versioduo/drum/drum.pdf

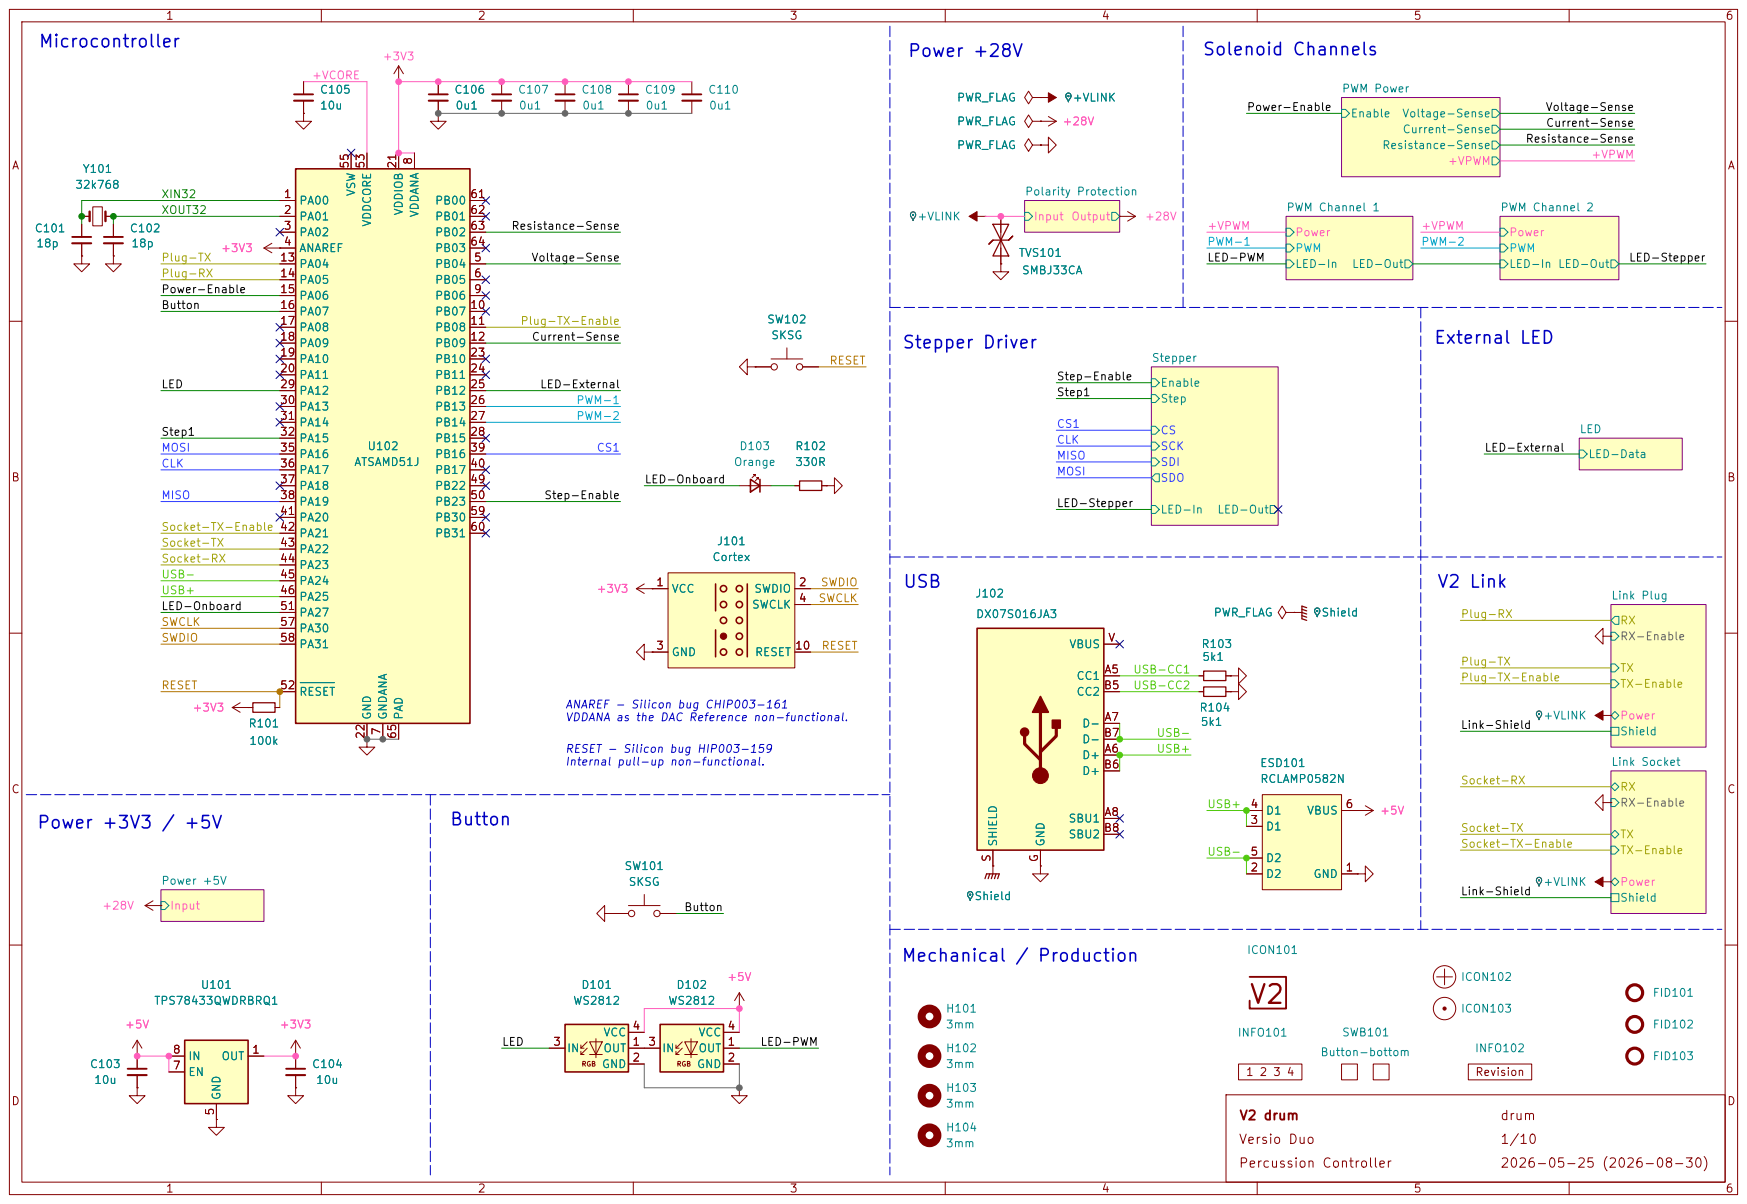
[picture p1: page 1]

Voltage-Sense Resistance-Sense +VPWM

XOUT32
Socket-RX Button Plug-TX Power-Enable Plug-RX

LED-Out Power PWM Channel 1

LED-Out Power PWM Channel 2

Stepper Driver | PWM-2 RESET

PWM-1 Plug-TX-Enable

Enable SDI LED-In SCK
Step

Step1 MOSI LED-Stepper CLK

LED-Onboard Socket-TX CLK

USB

TX-Enable Power Shield

ANAREF - Silicon bug CHIP003-161
VDDANA as the DAC Reference non-functional. RESET - Silicon bug HIP003-159

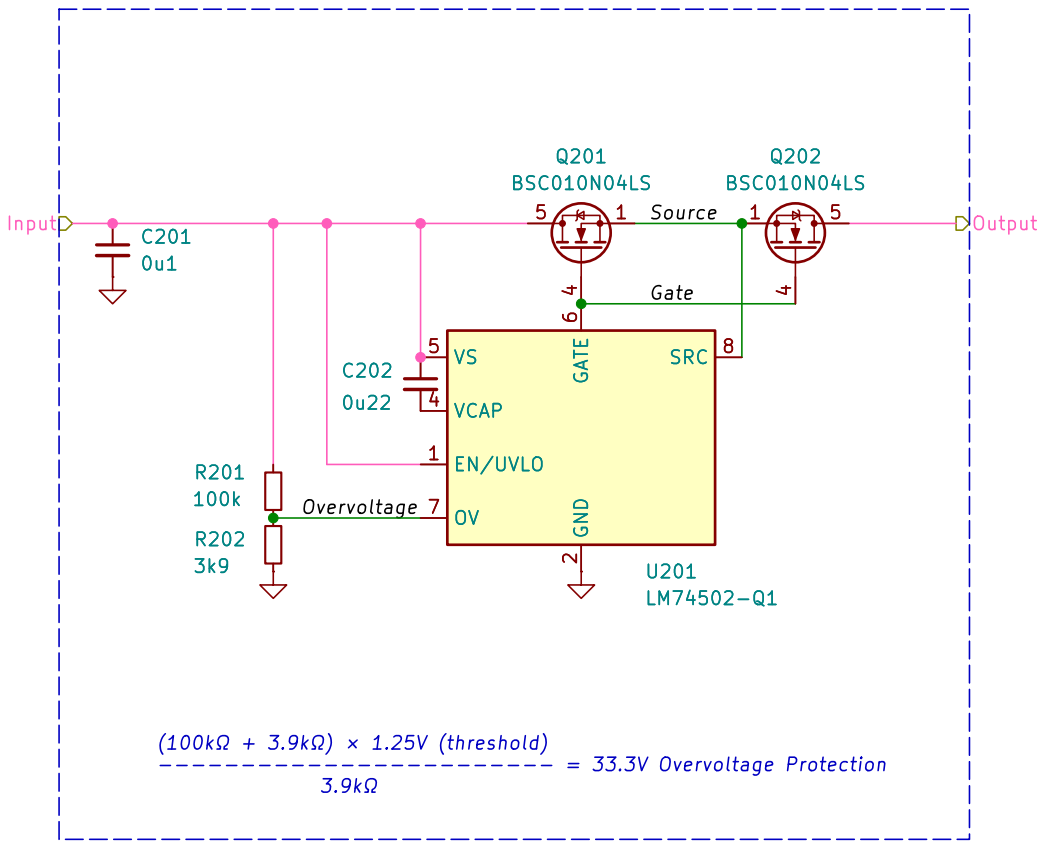
[picture p2: page 2]

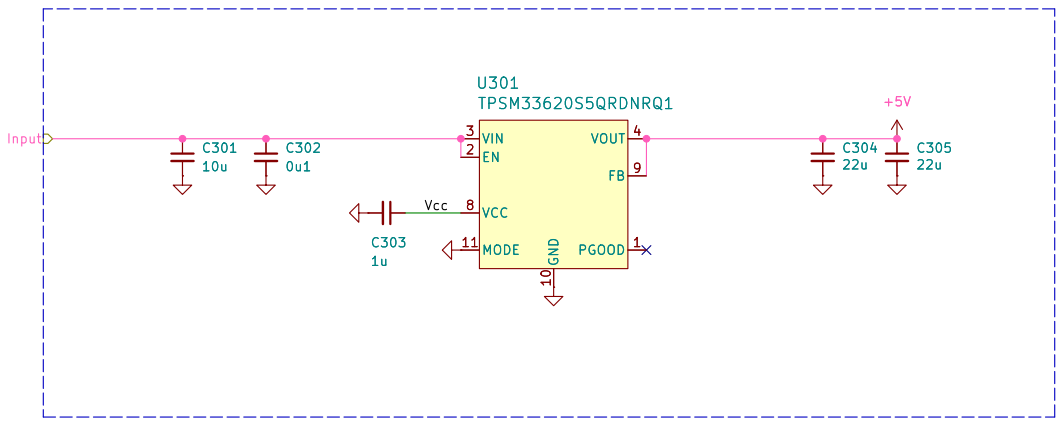
[picture p3: page 3]

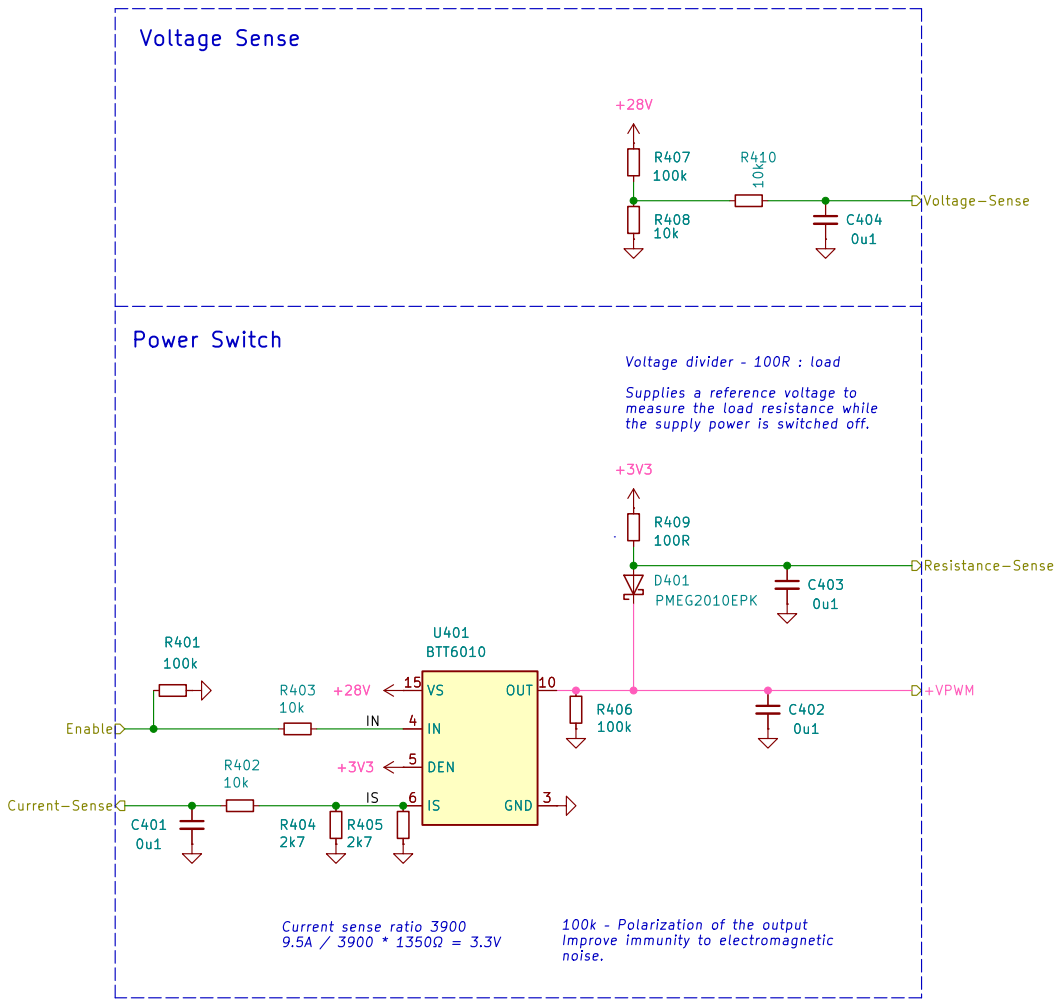
[picture p4: page 4]

Voltage divider – 100R : load Supplies a reference voltage to measure the load resistance while

the supply power is switched off. 100k – Polarization of the output

Improve immunity to electromagnetic noise.

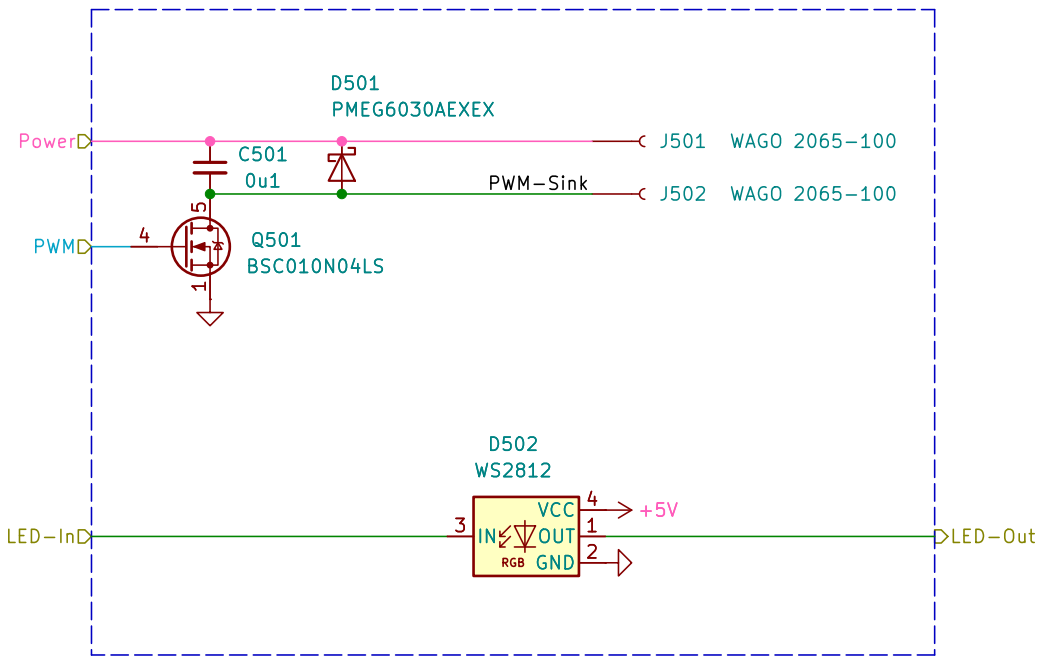
[picture p5: page 5]

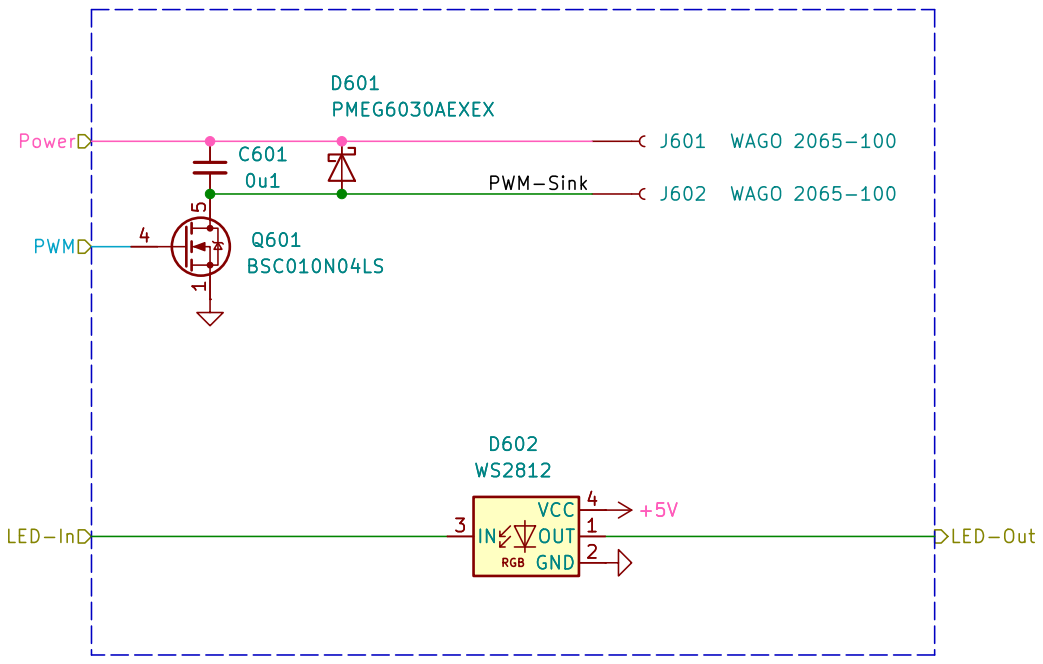
[picture p6: page 6]

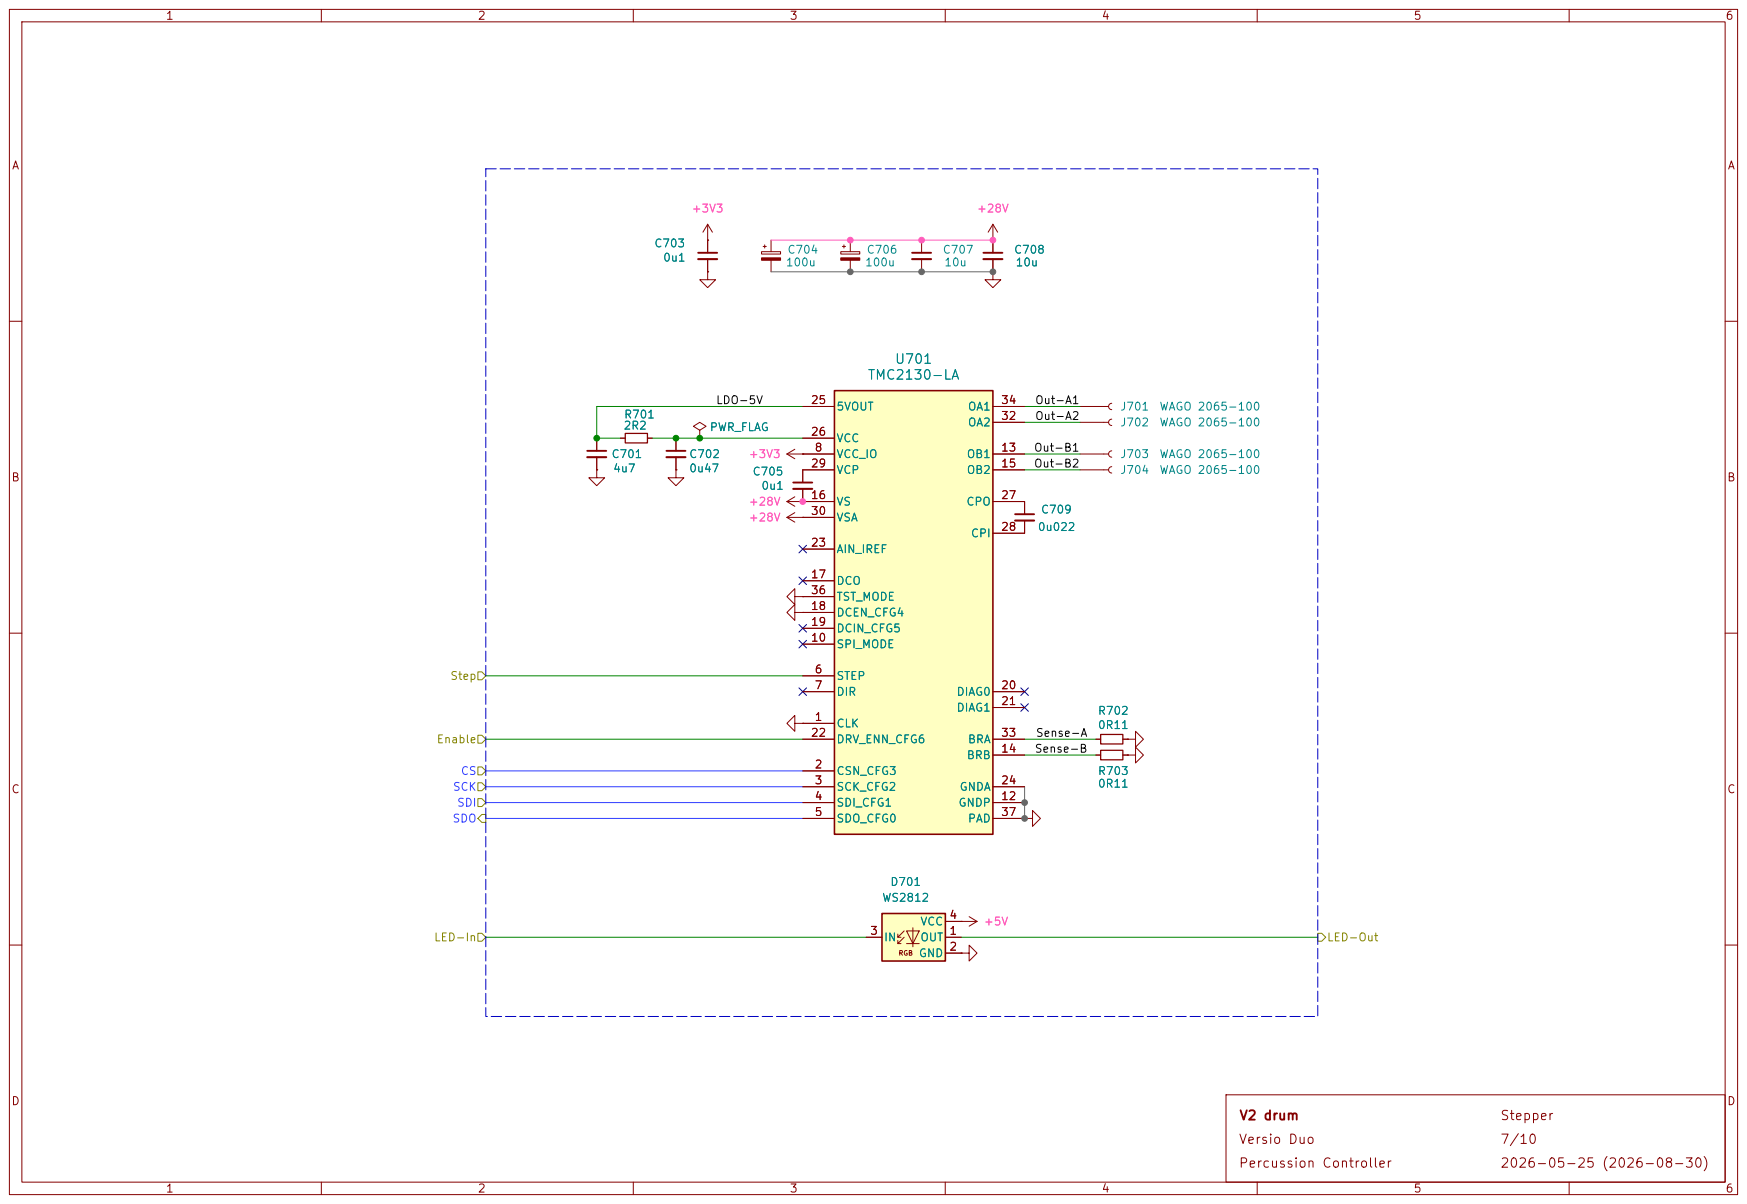
[picture p7: page 7]

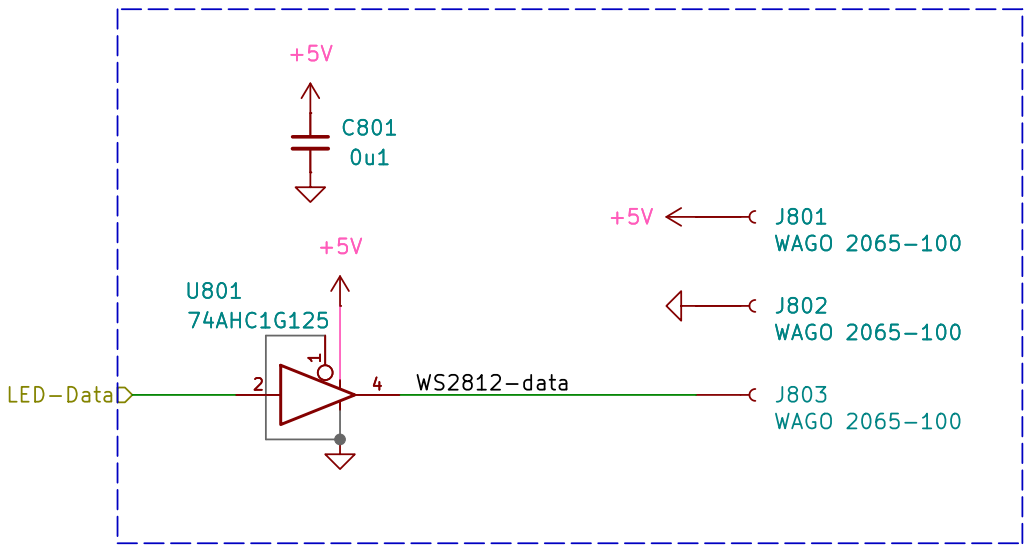
[picture p8: page 8]

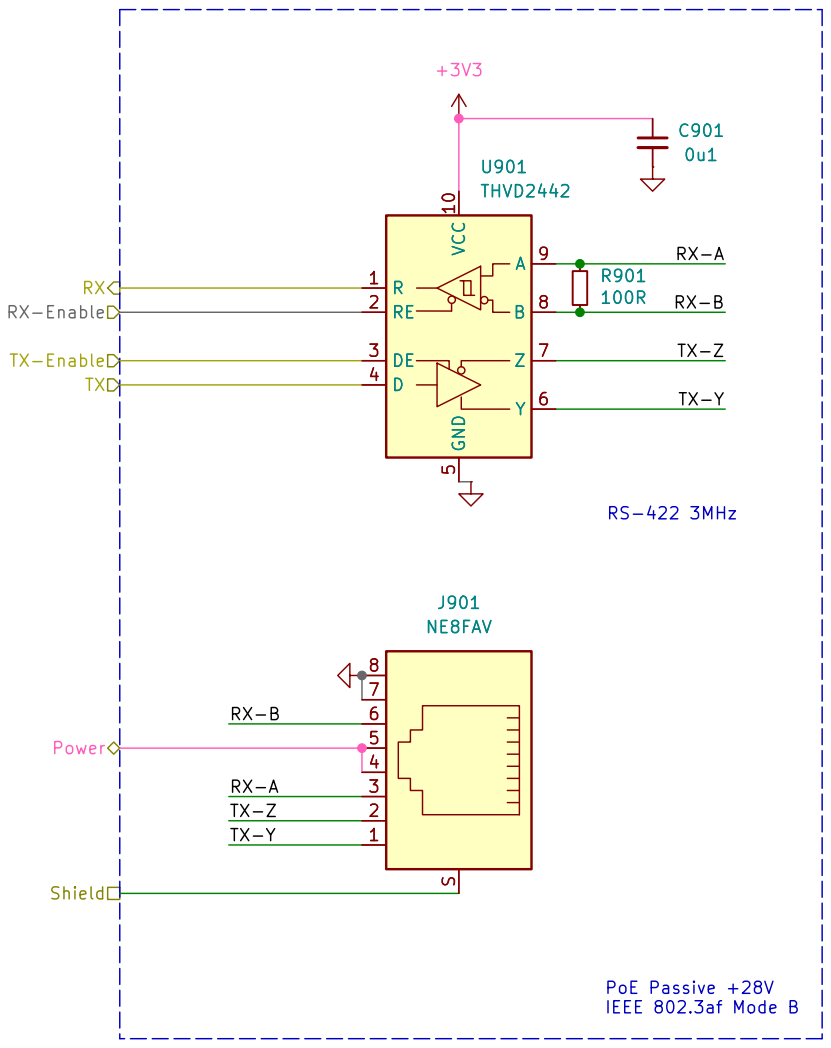
[picture p9: page 9]

Shield Power RX-Enable

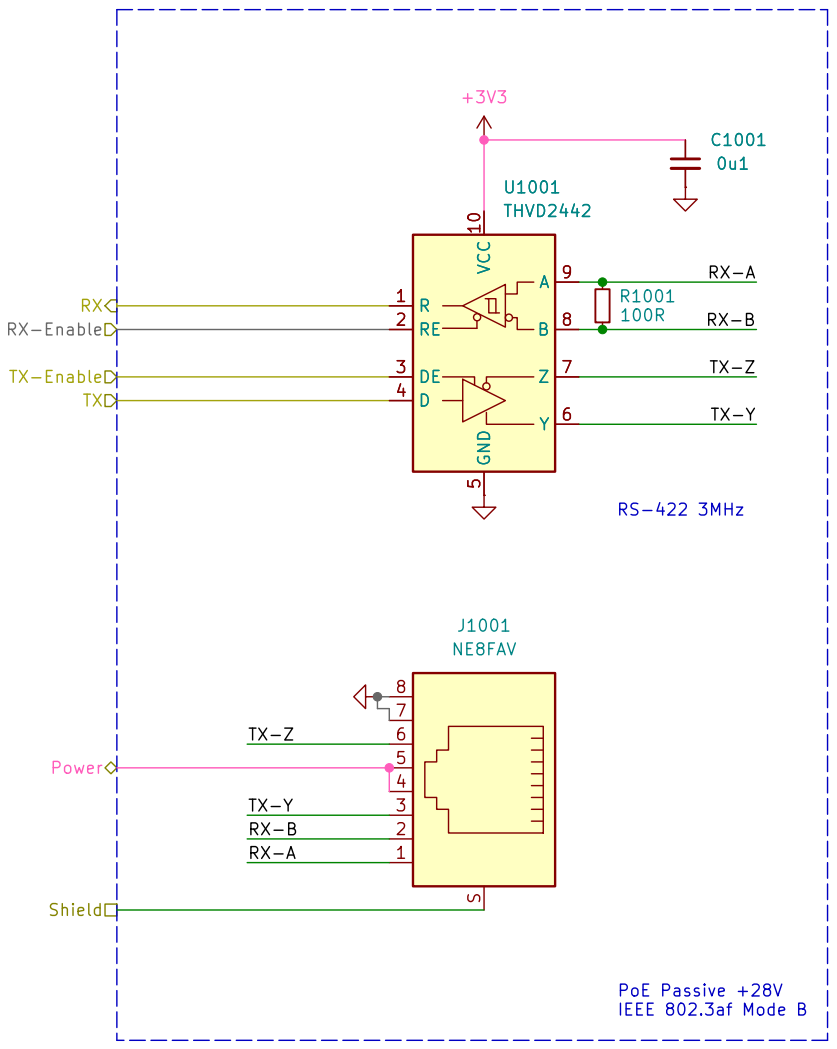
[picture p10: page 10]

IEEE 802.3af Mode B U1001
THVD2442
TX-Z RX-A RS-422 3MHz PoE Passive +28V

TX-Enable RX RX-Enable
