versioduo/drum/drum.kicad_pcb

## KiCad design drum.kicad_pcb (2026-08-30)

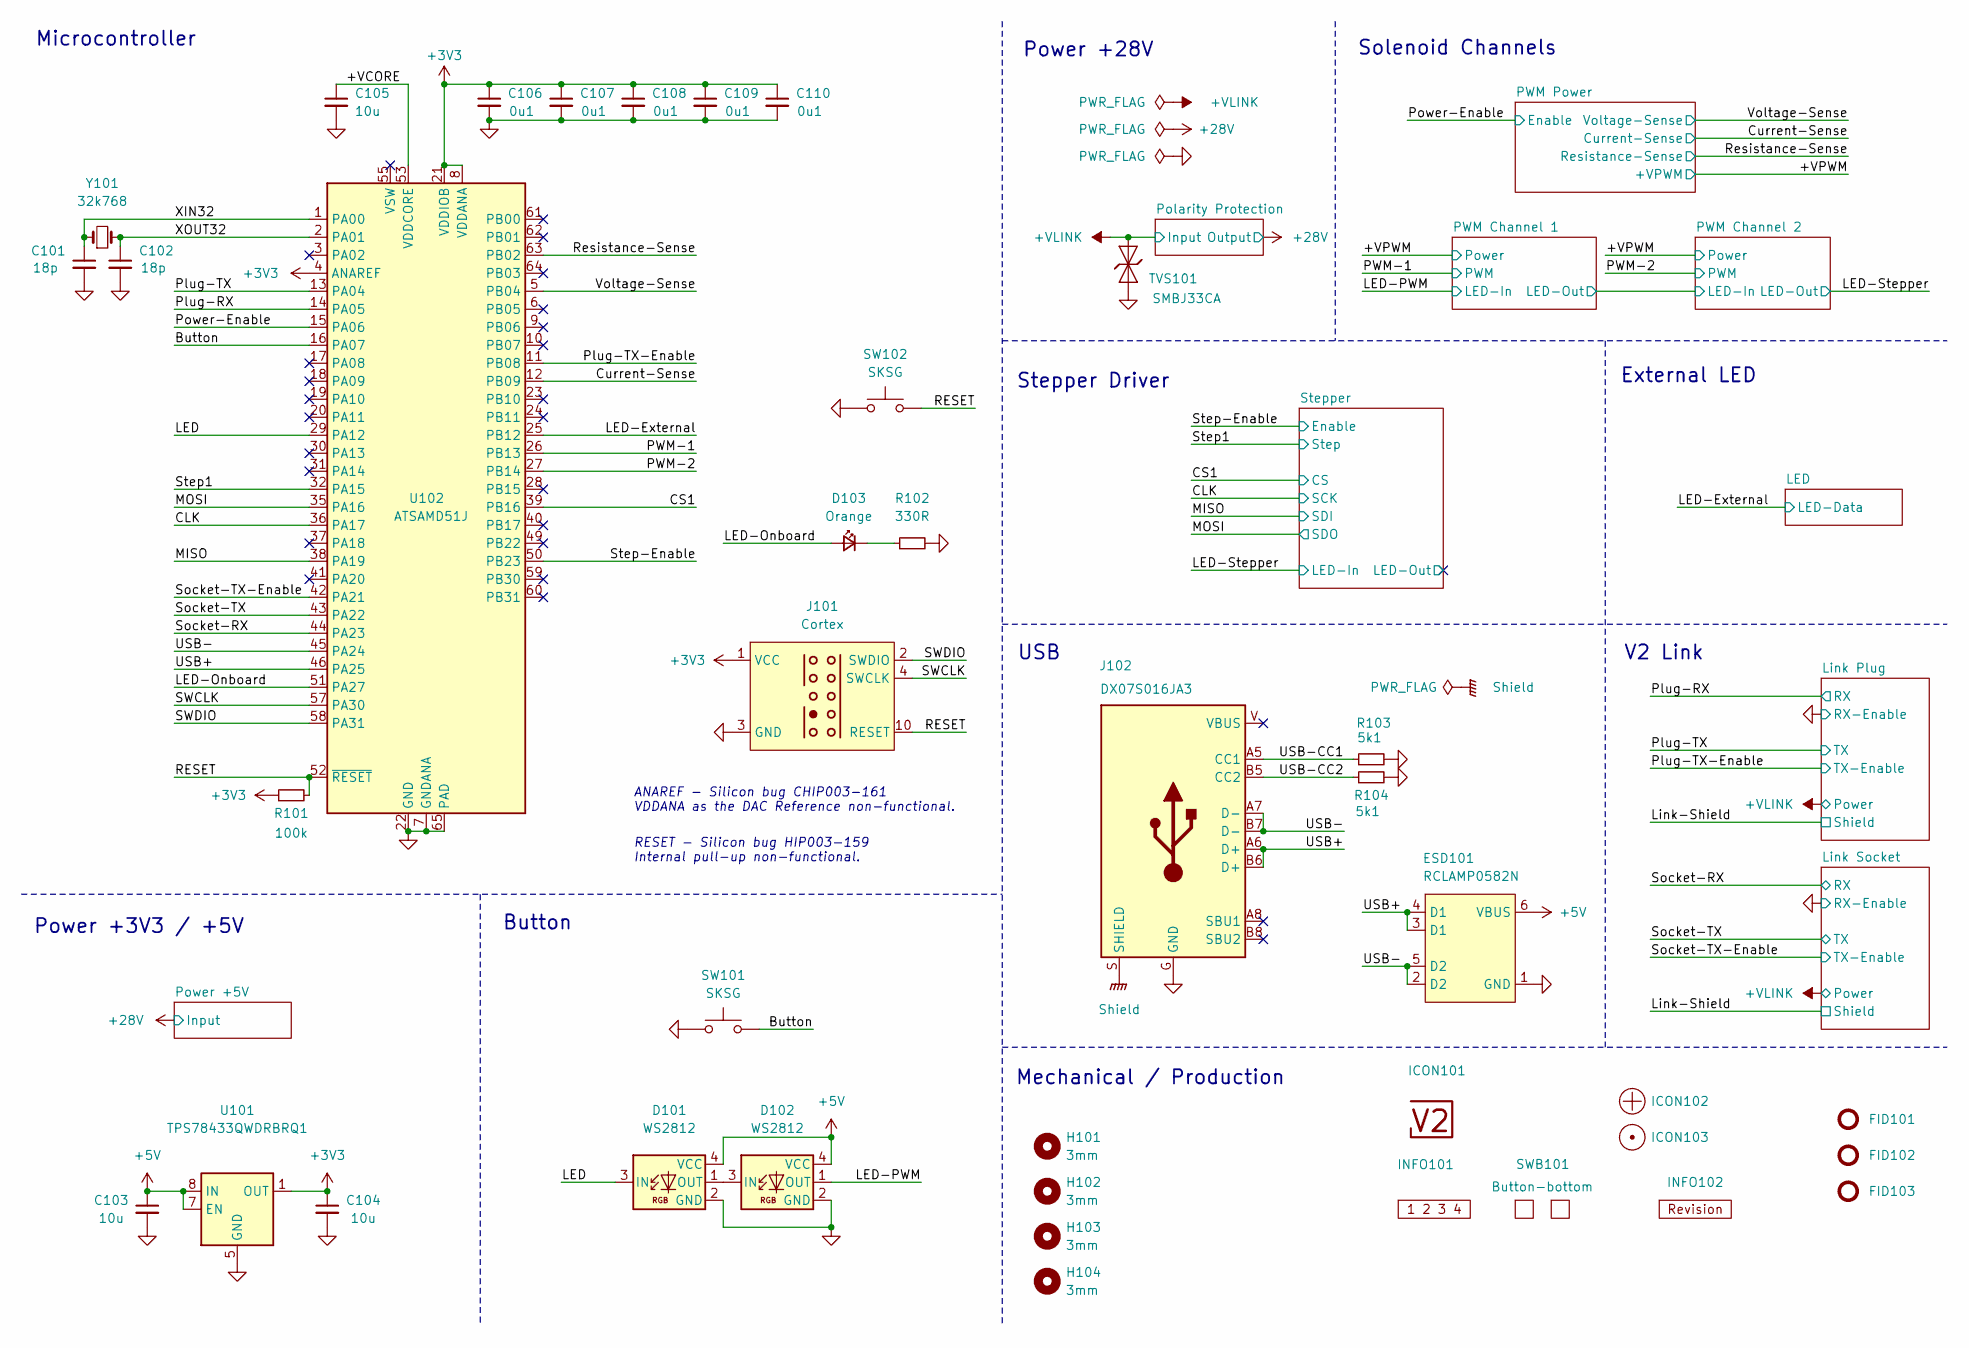
[picture p11: schematic drum.kicad_sch, V2 drum]

Parts:
C101, C102: 18p; C_1608; Rating 50V; Mouser 810-CGA3E2C0G1H180J
C103, C104: 10u; C_2012; Rating 25V; Mouser 810-C2012X5R1E106K
C105: 10u; C_1608; Rating 10V; Mouser 810-C1608X6S1A106M
C106, C107, C108, C109, C110: 0u1; C_1608; Rating 50V; Mouser 810-CGA3E2X7R1H104MA
D101, D102: WS2812; WS2812-2020; Rating 15mA; LCSC C965555
D103: Orange; LED_1608; Rating 605nm; Mouser 755-SML-D12D1WT86
ESD101: RCLAMP0582N; SLP1210N6; Rating 20kV; Mouser 947-RCLAMP0582N.TCT
FID101, FID102, FID103: Fiducial_Paste; Fiducial_0.5mm_Mask1mm_Paste
H101, H102, H103, H104: 3mm; MountingHole_3mm
ICON101: V2-logo; Logo_Small
ICON102: Plus; Plus_Small
ICON103: Dot; Dot_Small
INFO101: Layer_Numbers-6
INFO102: Revision
J101: Cortex
J102: DX07S016JA3; JAE_DX07S016JA3; Rating USB2.0; Mouser 656-DX07S016JA3R1500
R101: 100k; R_1608; Rating 100mW; Mouser 71-CRCW0603100KFKEAC
R102: 330R; R_1608; Rating 100mW; Mouser 71-CRCW0603330RFKEAC
R103, R104: 5k1; R_1608; Rating 100mW; Mouser 71-CRCW06035K10FKEAC
SW101, SW102: SKSG; Rating 1.6N; Mouser 688-SKSGACE010
SWB101: Button-bottom; PCB_Button-bottom
TVS101: SMBJ33CA; D_SMB; Rating 33V; Mouser 652-SMBJ33CA-Q
U101: TPS78433QWDRBRQ1; VSON-8-1_3x3mm_P0.65_EP1.65x2.4mm; Rating 300mA; Mouser 595-TPS78433QWDRBRQ1
U102: ATSAMD51J; QFN-64-1EP_9x9mm_P0.5mm_EP4.8x4.8mm_ThermalVias; Rating Cortex-M4F; Mouser 556-ATSAMD51J19AMU
Y101: 32k768; Crystal_SMD_3215-2Pin_3.2x1.5mm; Rating 10ppm; Mouser 815-ABS0716632.768KT

Connections:
+3V3: C104.1, C106.1, C107.1, C108.1, C109.1, C110.1, J101.1 (VCC), R101.1, U101.1 (OUT), U102.4 (ANAREF), U102.8 (VDDANA), U102.21 (VDDIOB), U102.34 (VDDIO), U102.48 (VDDIO), U102.56 (VDDIO); also elsewhere on the board
+5V: C103.1, D101.4 (VCC), D102.4 (VCC), ESD101.6 (VBUS), U101.6 (EN), U101.7 (EN), U101.8 (IN); also elsewhere on the board
/+VCORE: C105.1, U102.53 (VDDCORE)
/+VLINK: TVS101.2 (A); also elsewhere on the board
/Button: SW101.2, U102.16 (PA07)
/CLK: U102.36 (PA17); also elsewhere on the board
/CS1: U102.39 (PB16); also elsewhere on the board
/Current-Sense: U102.12 (PB09); also elsewhere on the board
/LED: D101.3 (IN), U102.29 (PA12)
/LED-External: U102.25 (PB12); also elsewhere on the board
/LED-Onboard: D103.2 (A), U102.51 (PA27)
/LED-PWM: D102.1 (OUT); also elsewhere on the board
/MISO: U102.38 (PA19); also elsewhere on the board
/MOSI: U102.35 (PA16); also elsewhere on the board
/PWM-1: U102.26 (PB13); also elsewhere on the board
/PWM-2: U102.27 (PB14); also elsewhere on the board
/Plug-RX: U102.14 (PA05); also elsewhere on the board
/Plug-TX: U102.13 (PA04); also elsewhere on the board
/Plug-TX-Enable: U102.11 (PB08); also elsewhere on the board
/Power-Enable: U102.15 (PA06); also elsewhere on the board
/RESET: J101.10 (RESET), R101.2, SW102.2, U102.52 (~RESET)
/Resistance-Sense: U102.63 (PB02); also elsewhere on the board
/SWCLK: J101.4 (SWCLK), U102.57 (PA30)
/SWDIO: J101.2 (SWDIO), U102.58 (PA31)
/Shield: J102.S (SHIELD)
/Socket-RX: U102.44 (PA23); also elsewhere on the board
/Socket-TX: U102.43 (PA22); also elsewhere on the board
/Socket-TX-Enable: U102.42 (PA21); also elsewhere on the board
/Step1: U102.32 (PA15); also elsewhere on the board
/Step-Enable: U102.50 (PB23); also elsewhere on the board
/USB+: ESD101.3 (D1), ESD101.4 (D1), J102.A6 (D+), J102.B6 (D+), U102.46 (PA25)
/USB-: ESD101.2 (D2), ESD101.5 (D2), J102.A7 (D-), J102.B7 (D-), U102.45 (PA24)
/USB-CC1: J102.A5 (CC1), R103.1
/USB-CC2: J102.B5 (CC2), R104.1
/Voltage-Sense: U102.5 (PB04); also elsewhere on the board
/XIN32: C101.1, U102.1 (PA00), Y101.1
/XOUT32: C102.1, U102.2 (PA01), Y101.2
GND: C101.2, C102.2, C103.2, C104.2, C105.2, C106.2, C107.2, C108.2, C109.2, C110.2, D101.2 (GND), D102.2 (GND), ESD101.1 (GND), J101.3 (GND), J101.5 (GND), J102.G (GND), R102.2, R103.2, R104.2, SW101.1, SW102.1, TVS101.1 (K), U101.5 (GND), U101.9 (GND), U102.7 (GNDANA), U102.22 (GND), U102.33 (GND), U102.47 (GND), U102.54 (GND), U102.65 (PAD); also elsewhere on the board
unnamed: D101.1 (OUT), D102.3 (IN)
unnamed: D103.1 (K), R102.1

Notes on the sheet:
 ANAREF - Silicon bug CHIP003-161 VDDANA as the DAC Reference non-functional.
Solenoid Channels
RESET -  Silicon bug HIP003-159 Internal pull-up non-functional.
Button
USB
Mechanical / Production
External LED
Power +3V3 / +5V
Stepper Driver
V2 Link
Microcontroller
Power +28V

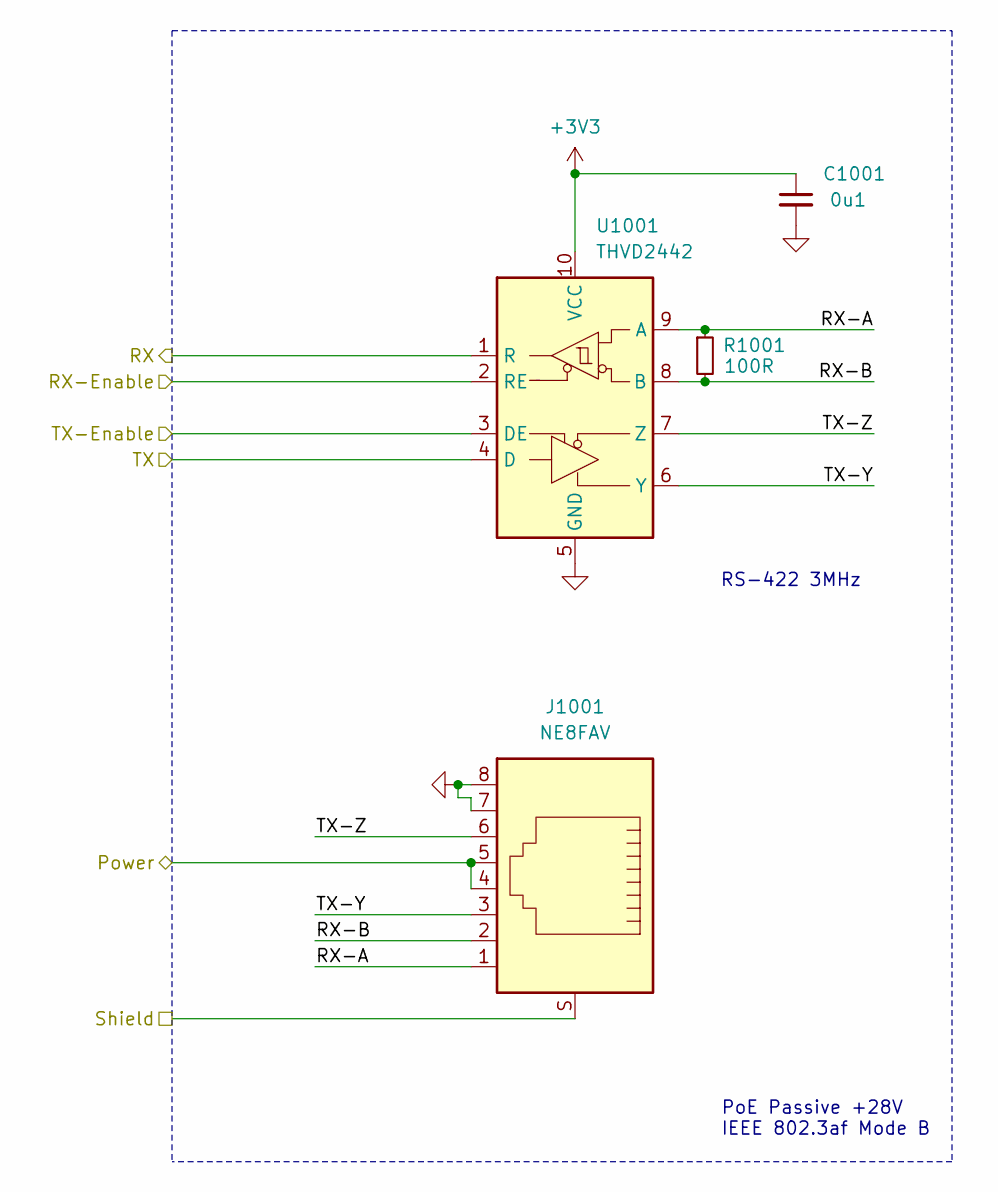
[picture p12: schematic Link-Socket.kicad_sch, V2 drum]

Parts:
C1001: 0u1; C_1608; Rating 50V; Mouser 810-CGA3E2X7R1H104MA
J1001: NE8FAV; Rating CAT5e; Mouser 568-NE8FAV-SD
R1001: 100R; R_1608; Rating 330mW; Mouser 71-CRCW0603100RFKEAH
U1001: THVD2442; VSON-10-4-1EP_3x3mm_P0.5mm_EP1.65x2.4mm_ThermalVias; Rating 20Mbps; Mouser 595-THVD2442DRCR

Connections:
+3V3: C1001.1, U1001.10 (VCC); also elsewhere on the board
/+VLINK: J1001.4, J1001.5; also elsewhere on the board
/Link Socket/RX-A: J1001.1, R1001.1, U1001.9 (A)
/Link Socket/RX-B: J1001.2, R1001.2, U1001.8 (B)
/Link Socket/TX-Y: J1001.3, U1001.6 (Y)
/Link Socket/TX-Z: J1001.6, U1001.7 (Z)
/Link-Shield: J1001.S; also elsewhere on the board
/Socket-RX: U1001.1 (R); also elsewhere on the board
/Socket-TX: U1001.4 (D); also elsewhere on the board
/Socket-TX-Enable: U1001.3 (DE); also elsewhere on the board
GND: C1001.2, J1001.7, J1001.8, U1001.2 (RE), U1001.5 (GND), U1001.11 (GND); also elsewhere on the board

Notes on the sheet:
PoE Passive +28V IEEE 802.3af Mode B
RS-422 3MHz

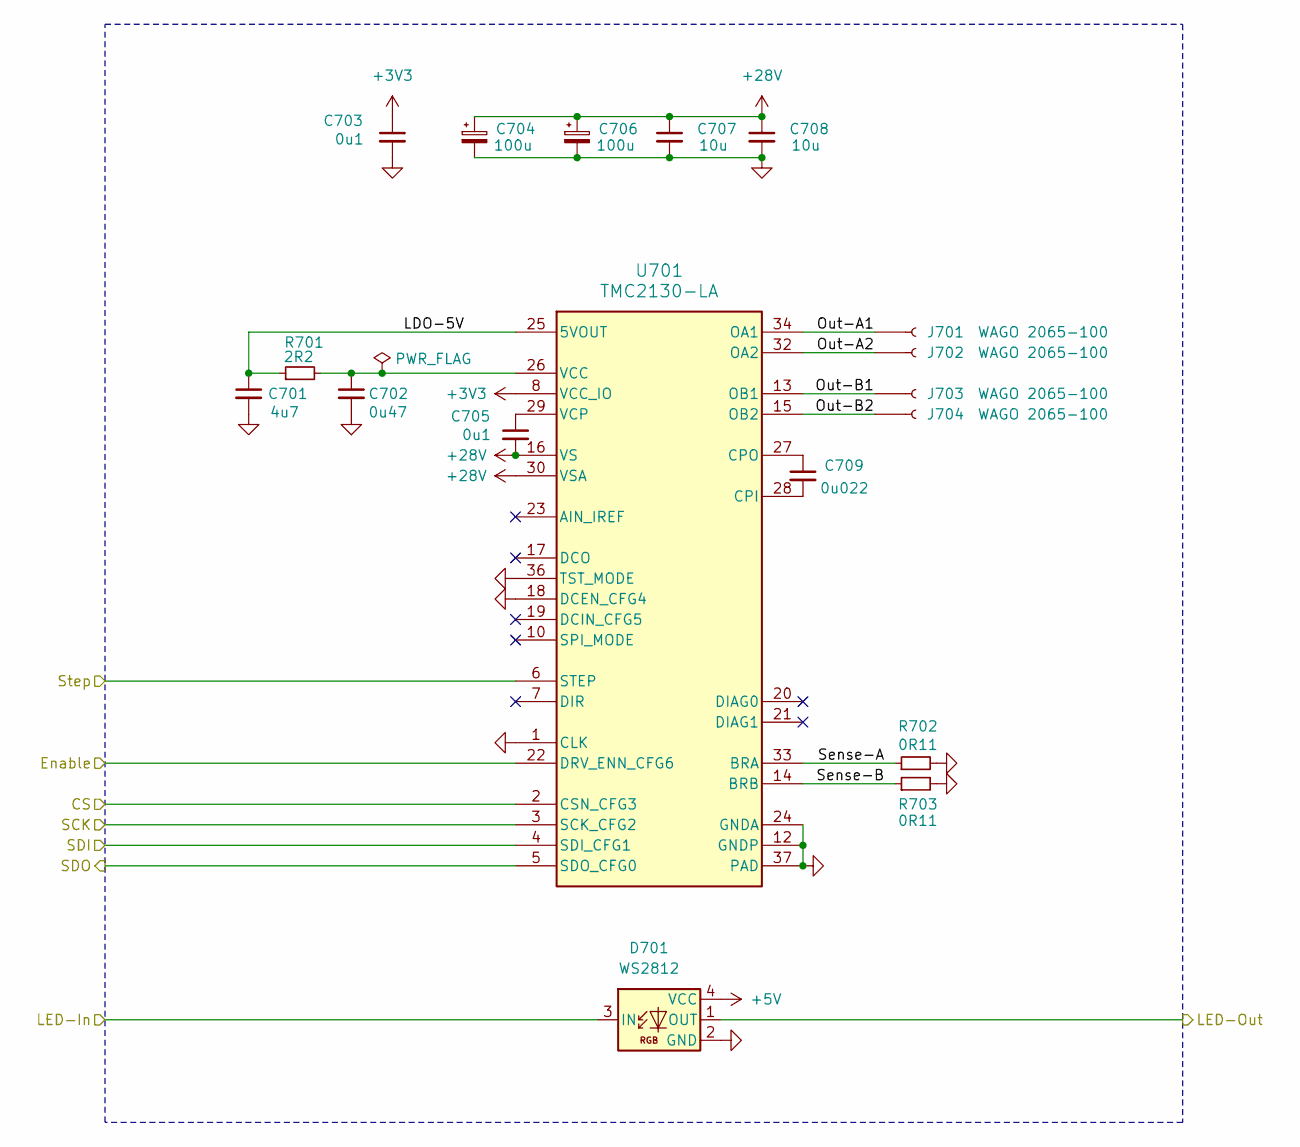
[picture p13: schematic Stepper.kicad_sch, V2 drum]

Parts:
C701: 4u7; C_1608; Rating 10V; Mouser 603-CC603KRX5R6BB475
C702: 0u47; C_1608; Rating 50V; Mouser 810-CGA3E3X7R1H474KB
C703, C705: 0u1; C_1608; Rating 50V; Mouser 810-CGA3E2X7R1H104MA
C704, C706: 100u; CP_Elec_6.3x7.7; Rating 35V; Mouser 667-EEE-FKV101XAL
C707, C708: 10u; C_3225; Rating 50V; Mouser 810-CNC6P1X7R1H106K2
C709: 0u022; C_1608; Rating 50V; Mouser 603-CC603KPX7R9BB223
D701: WS2812; WS2812-2020; Rating 15mA; LCSC C965555
J701, J702, J703, J704: WAGO 2065-100; 2065-100; Rating 9A
R701: 2R2; R_1608; Rating 500mW; Mouser 71-RCS06032R20JNEA
R702, R703: 0R11; R_2012; Rating 500mW; Mouser 667-ERJ-6DSFR11V
U701: TMC2130-LA; QFN-36-5X6; Rating 2A; LCSC C915795

Connections:
+3V3: C703.1, U701.8 (VCC_IO); also elsewhere on the board
+5V: D701.4 (VCC); also elsewhere on the board
+28V: C704.1, C705.2, C706.1, C707.1, C708.1, U701.16 (VS), U701.30 (VSA), U701.31 (VS); also elsewhere on the board
/CLK: U701.3 (SCK_CFG2); also elsewhere on the board
/CS1: U701.2 (CSN_CFG3); also elsewhere on the board
/LED-Stepper: D701.3 (IN); also elsewhere on the board
/MISO: U701.4 (SDI_CFG1); also elsewhere on the board
/MOSI: U701.5 (SDO_CFG0); also elsewhere on the board
/Step1: U701.6 (STEP); also elsewhere on the board
/Step-Enable: U701.22 (DRV_ENN_CFG6); also elsewhere on the board
/Stepper/LDO-5V: C701.1, R701.1, U701.25 (5VOUT)
/Stepper/LED-Out: D701.1 (OUT)
/Stepper/Out-A1: J701.1, U701.34 (OA1)
/Stepper/Out-A2: J702.1, U701.32 (OA2)
/Stepper/Out-B1: J703.1, U701.13 (OB1)
/Stepper/Out-B2: J704.1, U701.15 (OB2)
/Stepper/Sense-A: R702.1, U701.33 (BRA)
/Stepper/Sense-B: R703.1, U701.14 (BRB)
GND: C701.2, C702.2, C703.2, C704.2, C706.2, C707.2, C708.2, D701.2 (GND), R702.2, R703.2, U701.1 (CLK), U701.12 (GNDP), U701.18 (DCEN_CFG4), U701.24 (GNDA), U701.35 (GNDP), U701.36 (TST_MODE), U701.37 (PAD); also elsewhere on the board
unnamed: C709.2, U701.28 (CPI)
unnamed: C709.1, U701.27 (CPO)
unnamed: C702.1, R701.2, U701.26 (VCC)
unnamed: C705.1, U701.29 (VCP)

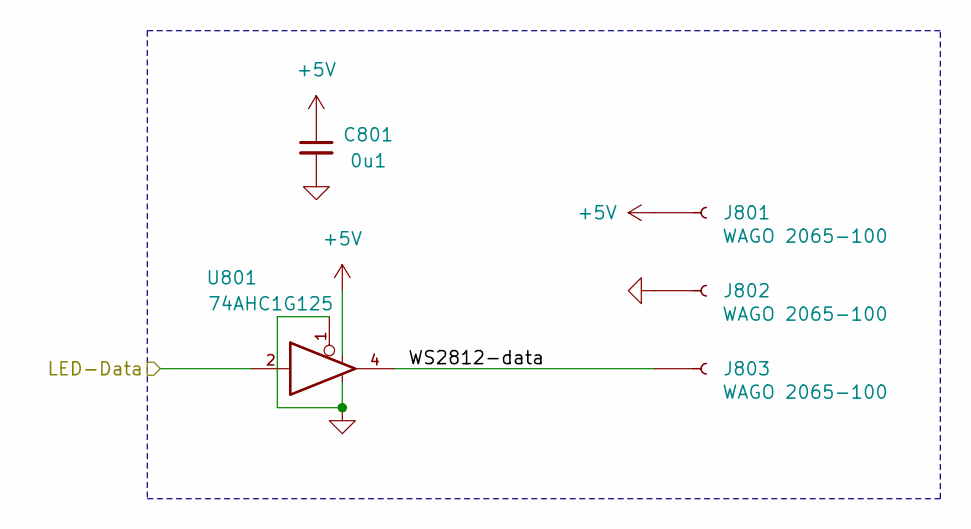
[picture p14: schematic LED.kicad_sch, V2 drum]

Parts:
C801: 0u1; C_1608; Rating 50V; Mouser 810-CGA3E2X7R1H104MA
J801, J802, J803: WAGO 2065-100; 2065-100; Rating 9A
U801: 74AHC1G125; SOT-23-5; Rating 8mA; Mouser 595-SN74AHC1G125DBVR

Connections:
+5V: C801.1, J801.1, U801.5; also elsewhere on the board
/LED-External: U801.2; also elsewhere on the board
/LED/WS2812-data: J803.1, U801.4
GND: C801.2, J802.1, U801.1, U801.3; also elsewhere on the board

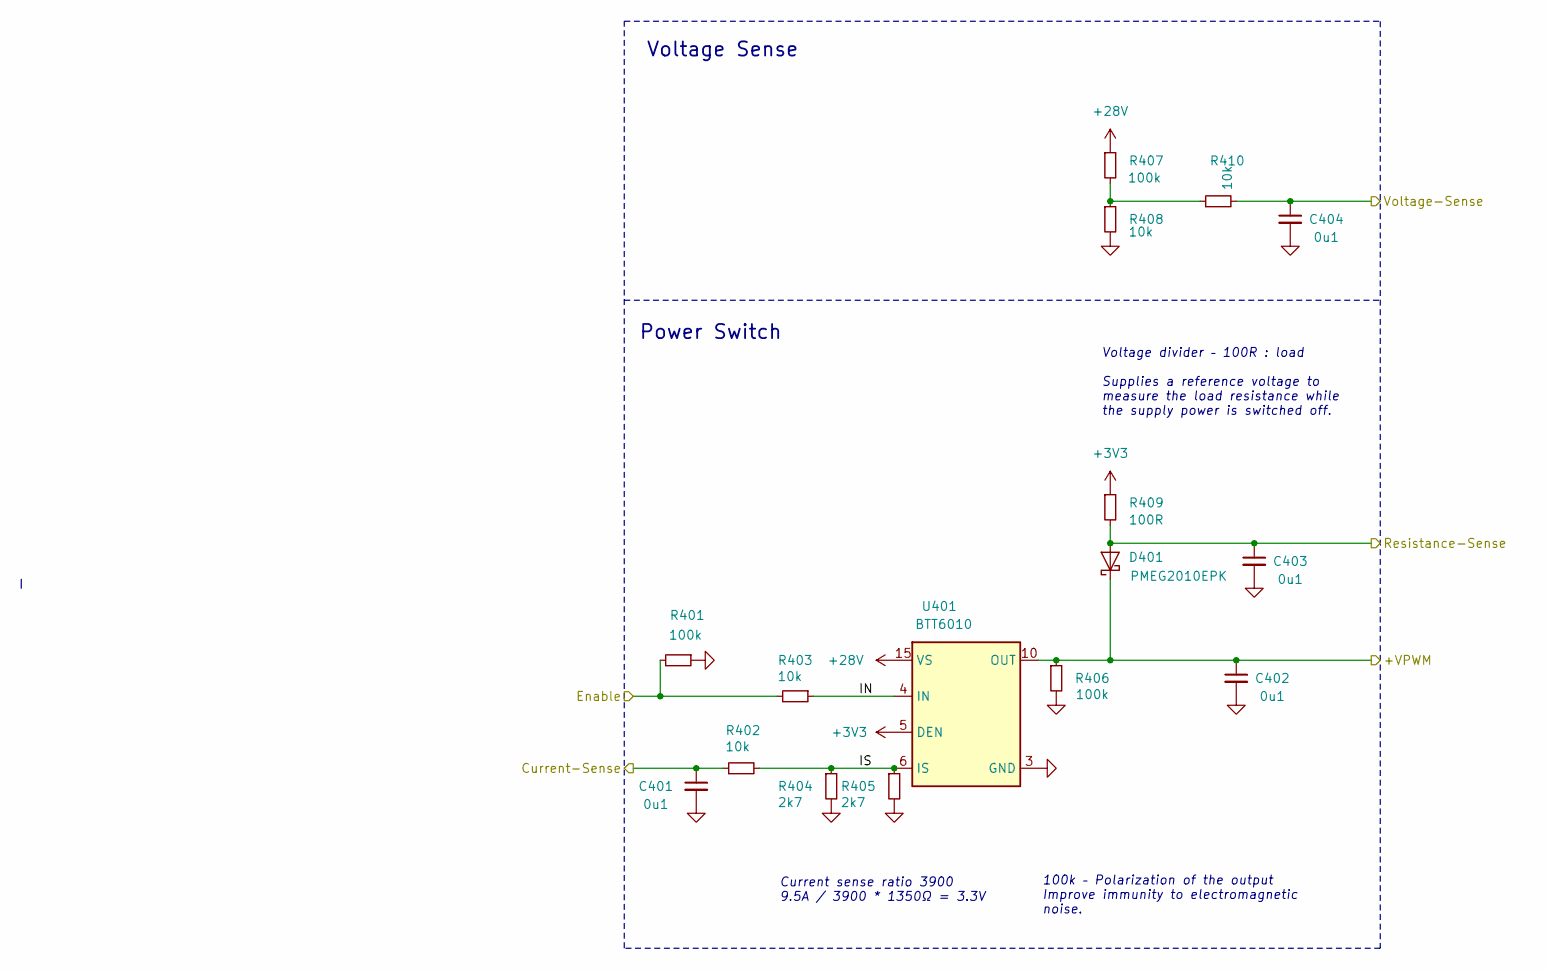
[picture p15: schematic Power-Switch.kicad_sch, V2 drum]

Parts:
C401, C402, C403, C404: 0u1; C_1608; Rating 50V; Mouser 810-CGA3E2X7R1H104MA
D401: PMEG2010EPK; D_SOD-1608; Rating 20V; Mouser 771-PMEG2010EPK
R401, R406, R407: 100k; R_1608; Rating 100mW; Mouser 71-CRCW0603100KFKEAC
R402, R403, R408, R410: 10k; R_1608; Rating 100mW; Mouser 71-CRCW060310K0FKEAC
R404, R405: 2k7; R_1608; Rating 100mW; Mouser 71-CRCW06032K70FKEAC
R409: 100R; R_1608; Rating 330mW; Mouser 71-CRCW0603100RFKEAH
U401: BTT6010; PG-TDS0-14; Rating 36V; Mouser 726-BTT60101ERBXUMA1

Connections:
+3V3: R409.1, U401.5 (DEN); also elsewhere on the board
+28V: R407.1, U401.15 (VS); also elsewhere on the board
/+VPWM: C402.1, D401.1 (K), R406.1, U401.10 (OUT), U401.11 (OUT), U401.12 (OUT); also elsewhere on the board
/Current-Sense: C401.1, R402.1; also elsewhere on the board
/PWM Power/IN: R403.1, U401.4 (IN)
/PWM Power/IS: R402.2, R404.1, R405.1, U401.6 (IS)
/Power-Enable: R401.2, R403.2; also elsewhere on the board
/Resistance-Sense: C403.1, D401.2 (A), R409.2; also elsewhere on the board
/Voltage-Sense: C404.1, R410.2; also elsewhere on the board
GND: C401.2, C402.2, C403.2, C404.2, R401.1, R404.2, R405.2, R406.2, R408.2, U401.3 (GND); also elsewhere on the board
unnamed: R407.2, R408.1, R410.1

Notes on the sheet:
100k – Polarization of the output Improve immunity to electromagnetic noise.
Current sense ratio 3900 9.5A / 3900 * 1350Ω = 3.3V
Voltage Sense
Power Switch
Voltage divider – 100R : load Supplies a reference voltage to measure the load resistance while the supply power is switched off.

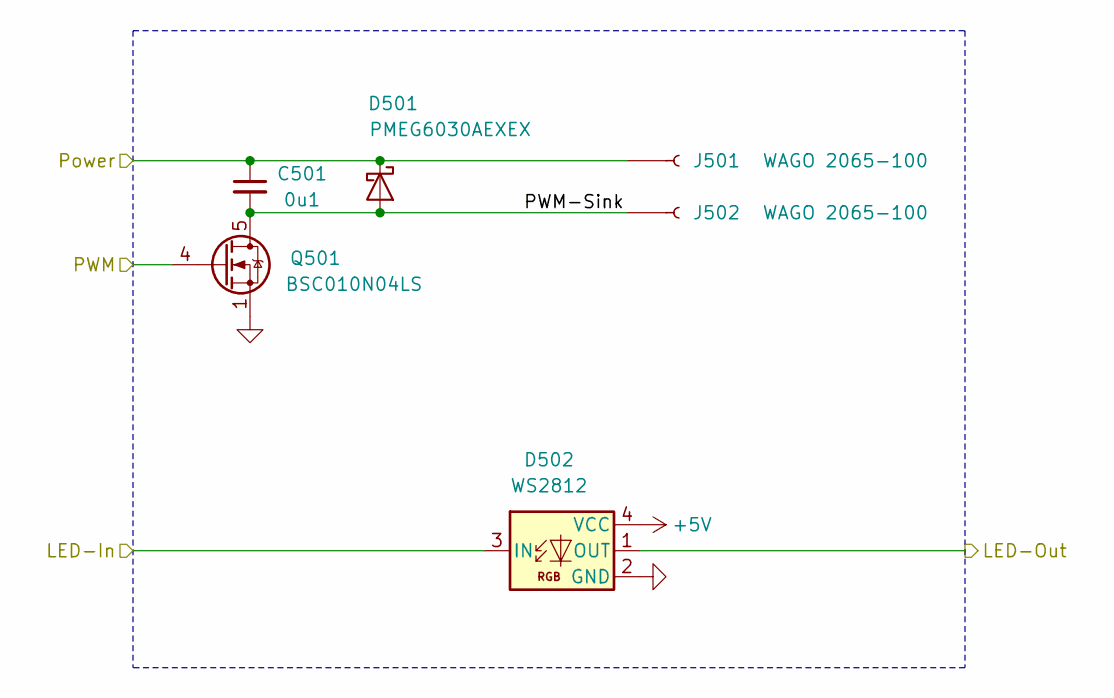
[picture p16: schematic PWM-Channel.kicad_sch, V2 drum]

Parts:
C501: 0u1; C_1608; Rating 50V; Mouser 810-CGA3E2X7R1H104MA
D501: PMEG6030AEXEX; D_SOD-123HP; Rating 60V; Mouser 771-PMEG6030AEXEX
D502: WS2812; WS2812-2020; Rating 15mA; LCSC C965555
J501, J502: WAGO 2065-100; 2065-100; Rating 9A
Q501: BSC010N04LS; TDSON-8-FL; Rating 40V; Mouser 726-BSC010N04LS

Connections:
+5V: D502.4 (VCC); also elsewhere on the board
/+VPWM: C501.1, D501.1 (K), J501.1; also elsewhere on the board
/LED-PWM: D502.3 (IN); also elsewhere on the board
/PWM Channel 1/LED-Out: D502.1 (OUT); also elsewhere on the board
/PWM Channel 1/PWM-Sink: C501.2, D501.2 (A), J502.1, Q501.5 (D)
/PWM-1: Q501.4 (G); also elsewhere on the board
GND: D502.2 (GND), Q501.1 (S); also elsewhere on the board

Parts of its further copies:
C601: 0u1; C_1608; Rating 50V; Mouser 810-CGA3E2X7R1H104MA
D601: PMEG6030AEXEX; D_SOD-123HP; Rating 60V; Mouser 771-PMEG6030AEXEX
D602: WS2812; WS2812-2020; Rating 15mA; LCSC C965555
J601, J602: WAGO 2065-100; 2065-100; Rating 9A
Q601: BSC010N04LS; TDSON-8-FL; Rating 40V; Mouser 726-BSC010N04LS

Connections of its further copies:
+5V: D602.4 (VCC); also elsewhere on the board
/+VPWM: C601.1, D601.1 (K), J601.1; also elsewhere on the board
/LED-Stepper: D602.1 (OUT); also elsewhere on the board
/PWM Channel 1/LED-Out: D602.3 (IN); also elsewhere on the board
/PWM Channel 2/PWM-Sink: C601.2, D601.2 (A), J602.1, Q601.5 (D)
/PWM-2: Q601.4 (G); also elsewhere on the board
GND: D602.2 (GND), Q601.1 (S); also elsewhere on the board

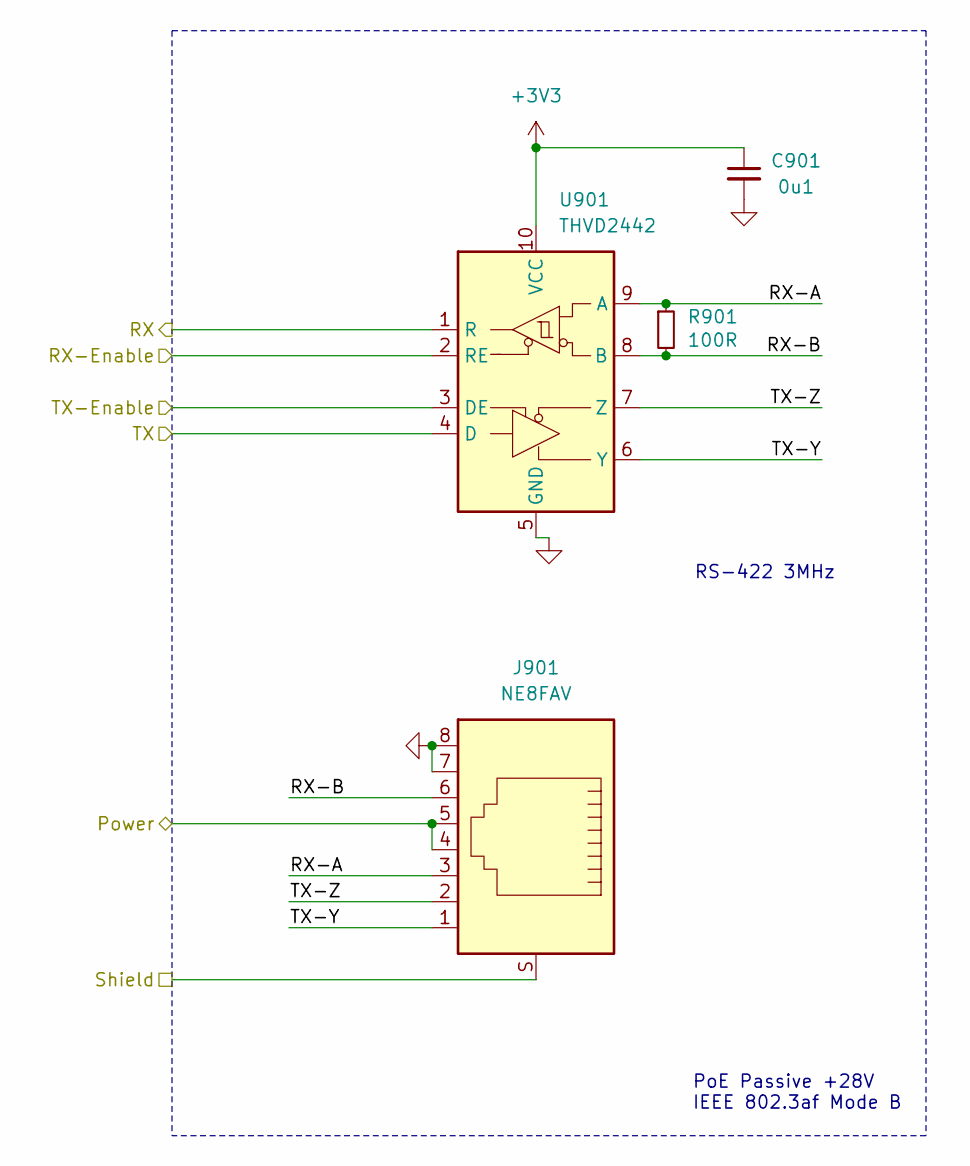
[picture p17: schematic Link-Plug.kicad_sch, V2 drum]

Parts:
C901: 0u1; C_1608; Rating 50V; Mouser 810-CGA3E2X7R1H104MA
J901: NE8FAV; Rating CAT5e; Mouser 568-NE8FAV-SD
R901: 100R; R_1608; Rating 330mW; Mouser 71-CRCW0603100RFKEAH
U901: THVD2442; VSON-10-4-1EP_3x3mm_P0.5mm_EP1.65x2.4mm_ThermalVias; Rating 20Mbps; Mouser 595-THVD2442DRCR

Connections:
+3V3: C901.1, U901.10 (VCC); also elsewhere on the board
/+VLINK: J901.4, J901.5; also elsewhere on the board
/Link Plug/RX-A: J901.3, R901.1, U901.9 (A)
/Link Plug/RX-B: J901.6, R901.2, U901.8 (B)
/Link Plug/TX-Y: J901.1, U901.6 (Y)
/Link Plug/TX-Z: J901.2, U901.7 (Z)
/Link-Shield: J901.S; also elsewhere on the board
/Plug-RX: U901.1 (R); also elsewhere on the board
/Plug-TX: U901.4 (D); also elsewhere on the board
/Plug-TX-Enable: U901.3 (DE); also elsewhere on the board
GND: C901.2, J901.7, J901.8, U901.2 (RE), U901.5 (GND), U901.11 (GND); also elsewhere on the board

Notes on the sheet:
RS-422 3MHz
PoE Passive +28V IEEE 802.3af Mode B

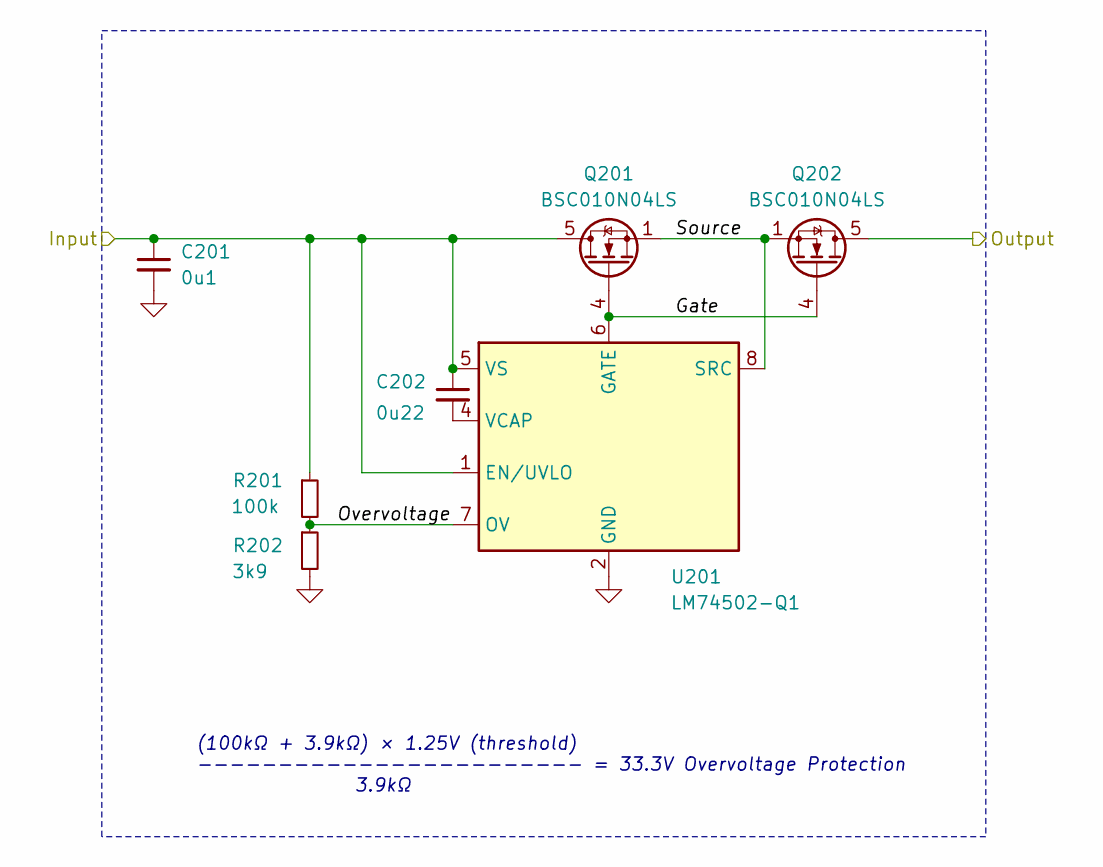
[picture p18: schematic Polarity-Protection.kicad_sch, V2 drum]

Parts:
C201: 0u1; C_1608; Rating 50V; Mouser 810-CGA3E2X7R1H104MA
C202: 0u22; C_1608; Rating 50V; Mouser 603-CC0603JRX79BB224
Q201, Q202: BSC010N04LS; TDSON-8-FL; Rating 40V; Mouser 726-BSC010N04LS
R201: 100k; R_1608; Rating 100mW; Mouser 71-CRCW0603100KFKEAC
R202: 3k9; R_1608; Rating 100mW; Mouser 71-CRCW06033K90FKEAC
U201: LM74502-Q1; SOT-23-8; Rating 60uA; Mouser 595-LM74502QDDFRQ1

Connections:
+28V: Q202.5 (D); also elsewhere on the board
/+VLINK: C201.1, C202.1, Q201.5 (D), R201.1, U201.1 (EN/UVLO), U201.5 (VS); also elsewhere on the board
/Polarity Protection/Gate: Q201.4 (G), Q202.4 (G), U201.6 (GATE)
/Polarity Protection/Overvoltage: R201.2, R202.1, U201.7 (OV)
/Polarity Protection/Source: Q201.1 (S), Q202.1 (S), U201.8 (SRC)
GND: C201.2, R202.2, U201.2 (GND); also elsewhere on the board
unnamed: C202.2, U201.4 (VCAP)

Notes on the sheet:
(100kΩ + 3.9kΩ) × 1.25V (threshold) ------------------------ = 33.3V Overvoltage Protection 3.9kΩ

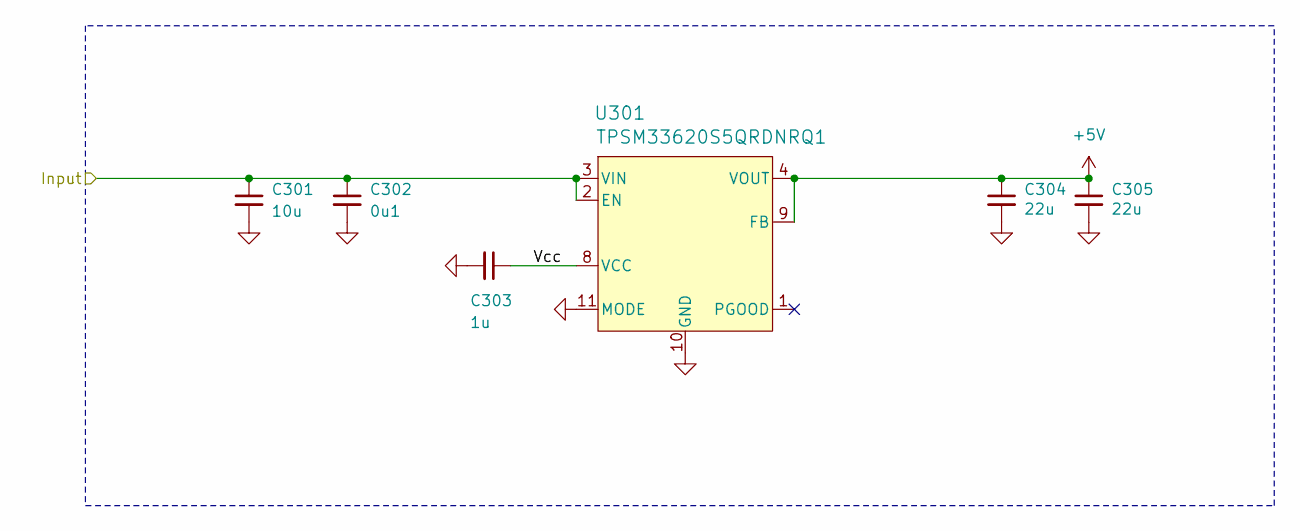
[picture p19: schematic Power-DCDC.kicad_sch, V2 drum]

Parts:
C301: 10u; C_3225; Rating 50V; Mouser 810-CNC6P1X7R1H106K2
C302: 0u1; C_1608; Rating 50V; Mouser 810-CGA3E2X7R1H104MA
C303: 1u; C_1608; Rating 50V; Mouser 810-CGA3E3X7R1H105K0
C304, C305: 22u; C_3225; Rating 25V; Mouser 810-CGA6P3X7R1E226M5
U301: TPSM33620S5QRDNRQ1; QFN-11; Rating 2A; Mouser 595-SM33620S5QRDNRQ1

Connections:
+5V: C304.1, C305.1, U301.4 (VOUT), U301.9 (FB); also elsewhere on the board
+28V: C301.1, C302.1, U301.2 (EN), U301.3 (VIN); also elsewhere on the board
/Power +5V/Vcc: C303.1, U301.8 (VCC)
GND: C301.2, C302.2, C303.2, C304.2, C305.2, U301.10 (GND), U301.11 (MODE); also elsewhere on the board

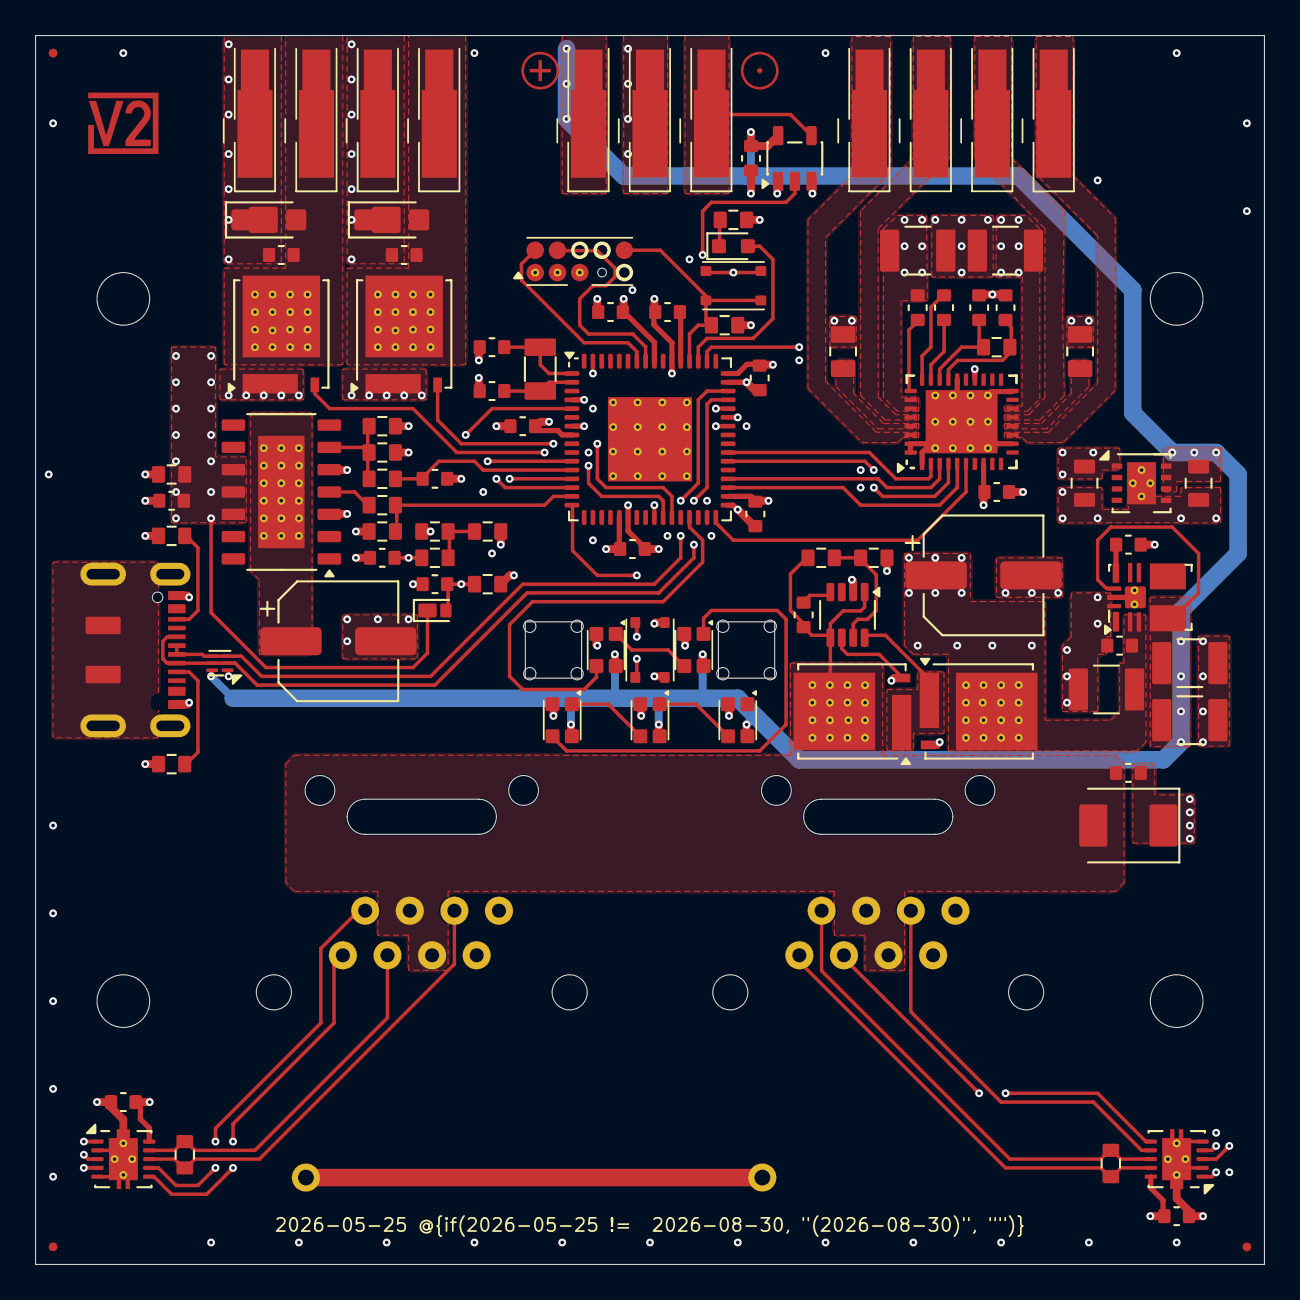
[picture p20: board drum.kicad_pcb from above]

Board: 6 copper layers, 70.0 x 70.0 mm, 111 parts (0 on the bottom side), 74 nets.
