versioduo/drum/(commit log)

2026-01-14 Update parts
    [LEDStrip.kicad_sch, LinkPlug.kicad_sch, LinkSocket.kicad_sch, PWMChannel.kicad_sch, PolarityProtection.kicad_sch, PowerSupply.kicad_sch, PowerSwitch.kicad_sch, StepperDriver.kicad_sch]
2026-01-27 Update library
    [LEDStrip.kicad_sch, LinkPlug.kicad_sch, LinkSocket.kicad_sch, PWMChannel.kicad_sch, PolarityProtection.kicad_sch, PowerSupply.kicad_sch, PowerSwitch.kicad_sch, StepperDriver.kicad_sch]
2026-02-10 Use date as revision
    [PolarityProtection.kicad_sch, drum.kicad_pcb, drum.kicad_sch]
2026-02-13 Replace Order_Number
    [drum.kicad_pcb, drum.kicad_sch]
2026-03-11 Replace diode
    [LEDStrip.kicad_sch, LinkPlug.kicad_sch, LinkSocket.kicad_sch, PWMChannel.kicad_sch, PolarityProtection.kicad_sch, PowerSupply.kicad_sch, PowerSwitch.kicad_sch, StepperDriver.kicad_sch]
2026-03-14 Update ESD suppressor
    [PWMChannel.kicad_sch, drum.kicad_pcb, drum.kicad_sch]
2026-03-31 Replace step-down
    [PowerSupply.kicad_sch, drum.kicad_pcb, drum.kicad_sch]
2026-05-11 Good Bye Imperial
    [LEDStrip.kicad_sch, LinkPlug.kicad_sch, LinkSocket.kicad_sch, PWMChannel.kicad_sch, PolarityProtection.kicad_sch, PowerSupply.kicad_sch, PowerSwitch.kicad_sch, StepperDriver.kicad_sch]
2026-05-27 Switch to 6 layer
    [LEDStrip.kicad_sch, LinkPlug.kicad_sch, LinkSocket.kicad_sch, PWMChannel.kicad_sch, PolarityProtection.kicad_sch, PowerSupply.kicad_sch, PowerSwitch.kicad_sch, StepperDriver.kicad_sch]
2026-06-08 Fix fiducial
    [drum.kicad_pcb]
